HaileyMakane/SafeCampus/Images/telegram_bot.png

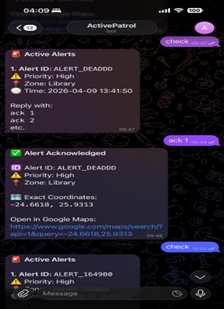
Images/telegram_bot.png
