HaileyMakane/SafeCampus/Images/security dashboard.png

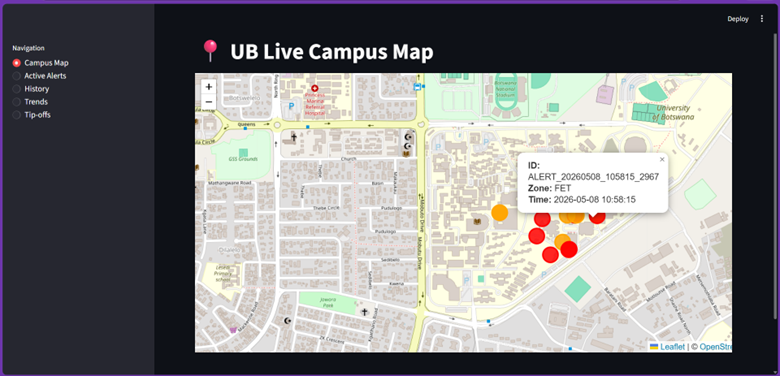
Images/security dashboard.png
