HaileyMakane/SafeCampus/Images/alert priority on dashboard.png

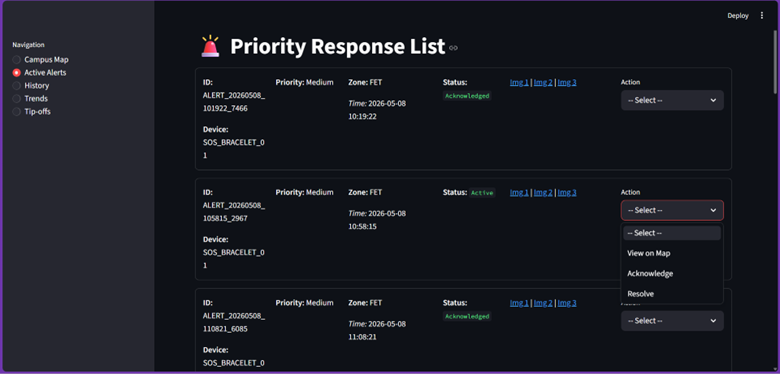
Images/alert priority on dashboard.png
