HaileyMakane/SafeCampus/Images/anonymous tip off sent on student app.png

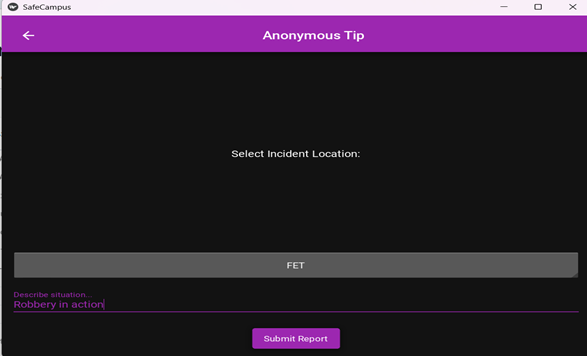
Images/anonymous tip off sent on student app.png
