HaileyMakane/SafeCampus/Images/bracelt prototype.png

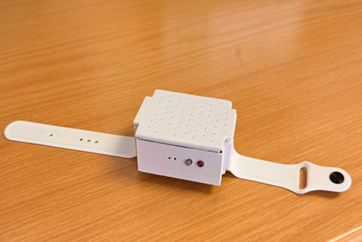
Images/bracelt prototype.png
