HaileyMakane/SafeCampus/Images/campus_pulse on student app.png

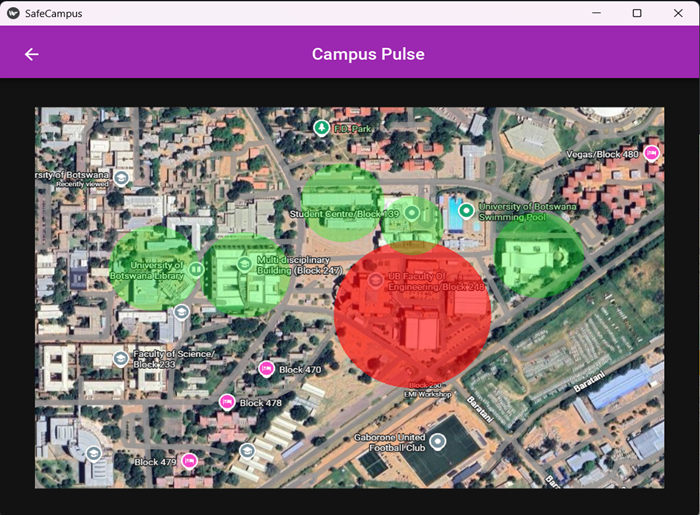
Images/campus_pulse on student app.png
