HaileyMakane/SafeCampus/Images/clip-on_cam.png

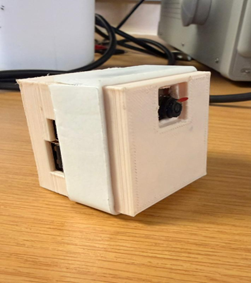
Images/clip-on_cam.png
