HaileyMakane/SafeCampus/Images/Picture14.png

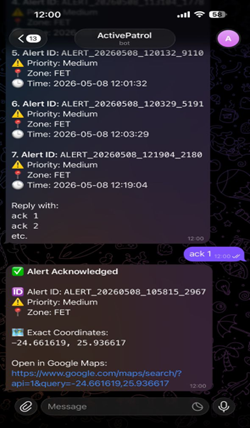
Images/Picture14.png
