HaileyMakane/SafeCampus/Images/Picture15.png

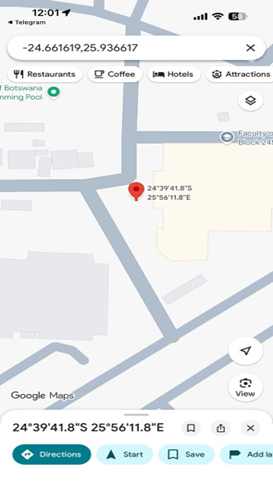
Images/Picture15.png
