HaileyMakane/SafeCampus/Images/Warnings_on student app.png

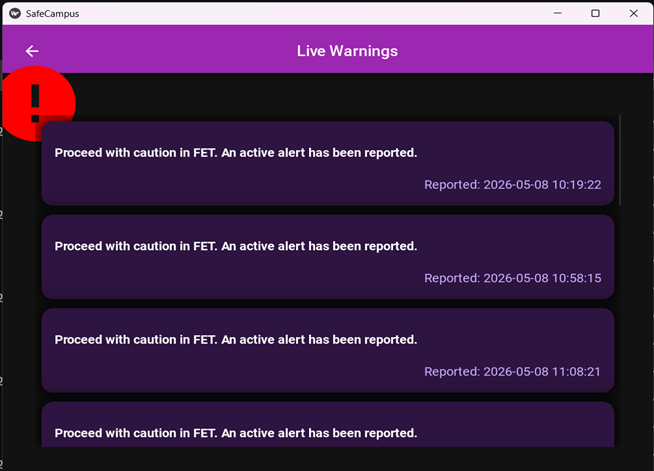
Images/Warnings_on student app.png
