HaileyMakane/SafeCampus/Images/incident history on security dashboard.png

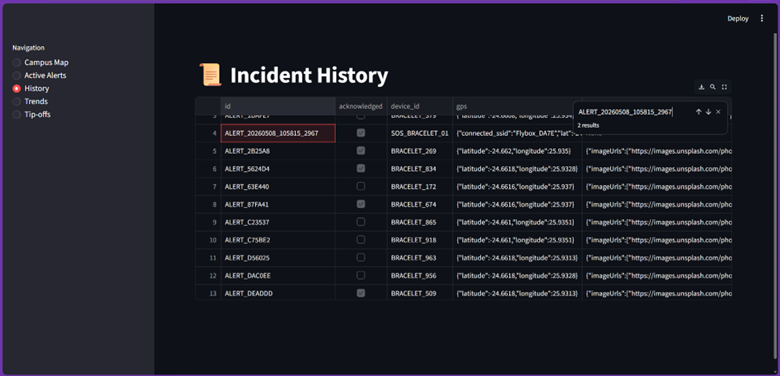
Images/incident history on security dashboard.png
